shuki25/chess-board-iot/Schematic PDFs/chess-board-iot.pdf

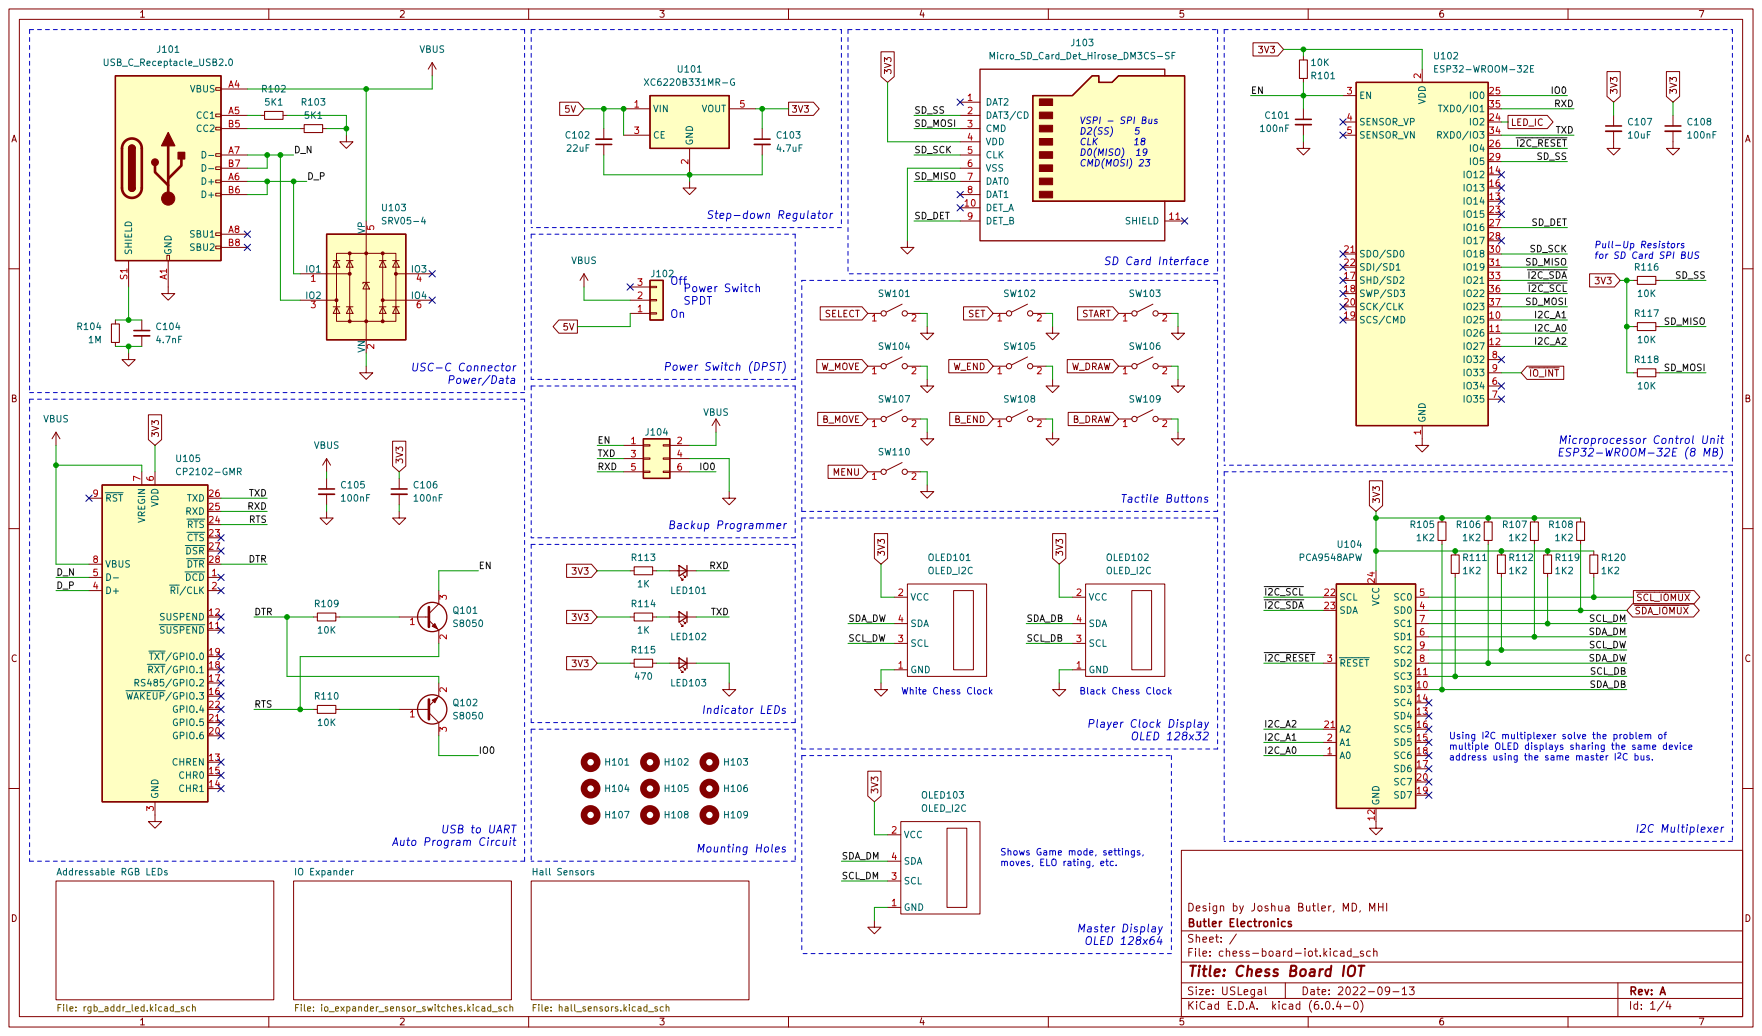
[picture p1: page 1]

2 SCK/CLK 20 SDO/SD0 21 SDI/SD1 22

SD Card Interface Player Clock Display OLED 128x32 Shows Game mode, settings,

Pull-Up Resistors
for SD Card SPI BUS Microprocessor Control Unit

Power Switch (DPST) Power Switch SPDT

SCL_DW
SDA_DW
SCL_DB

multiple OLED displays sharing the same device
address using the same master I^{2}C bus.

File: chess-board-iot.kicad_sch Sheet: / Butler Electronics Design by Joshua Butler, MD, MHI
D Date: 2022-09-13 KiCad E.D.A. kicad (6.0.4-0)

Id: 1/4 Title: Chess Board IOT

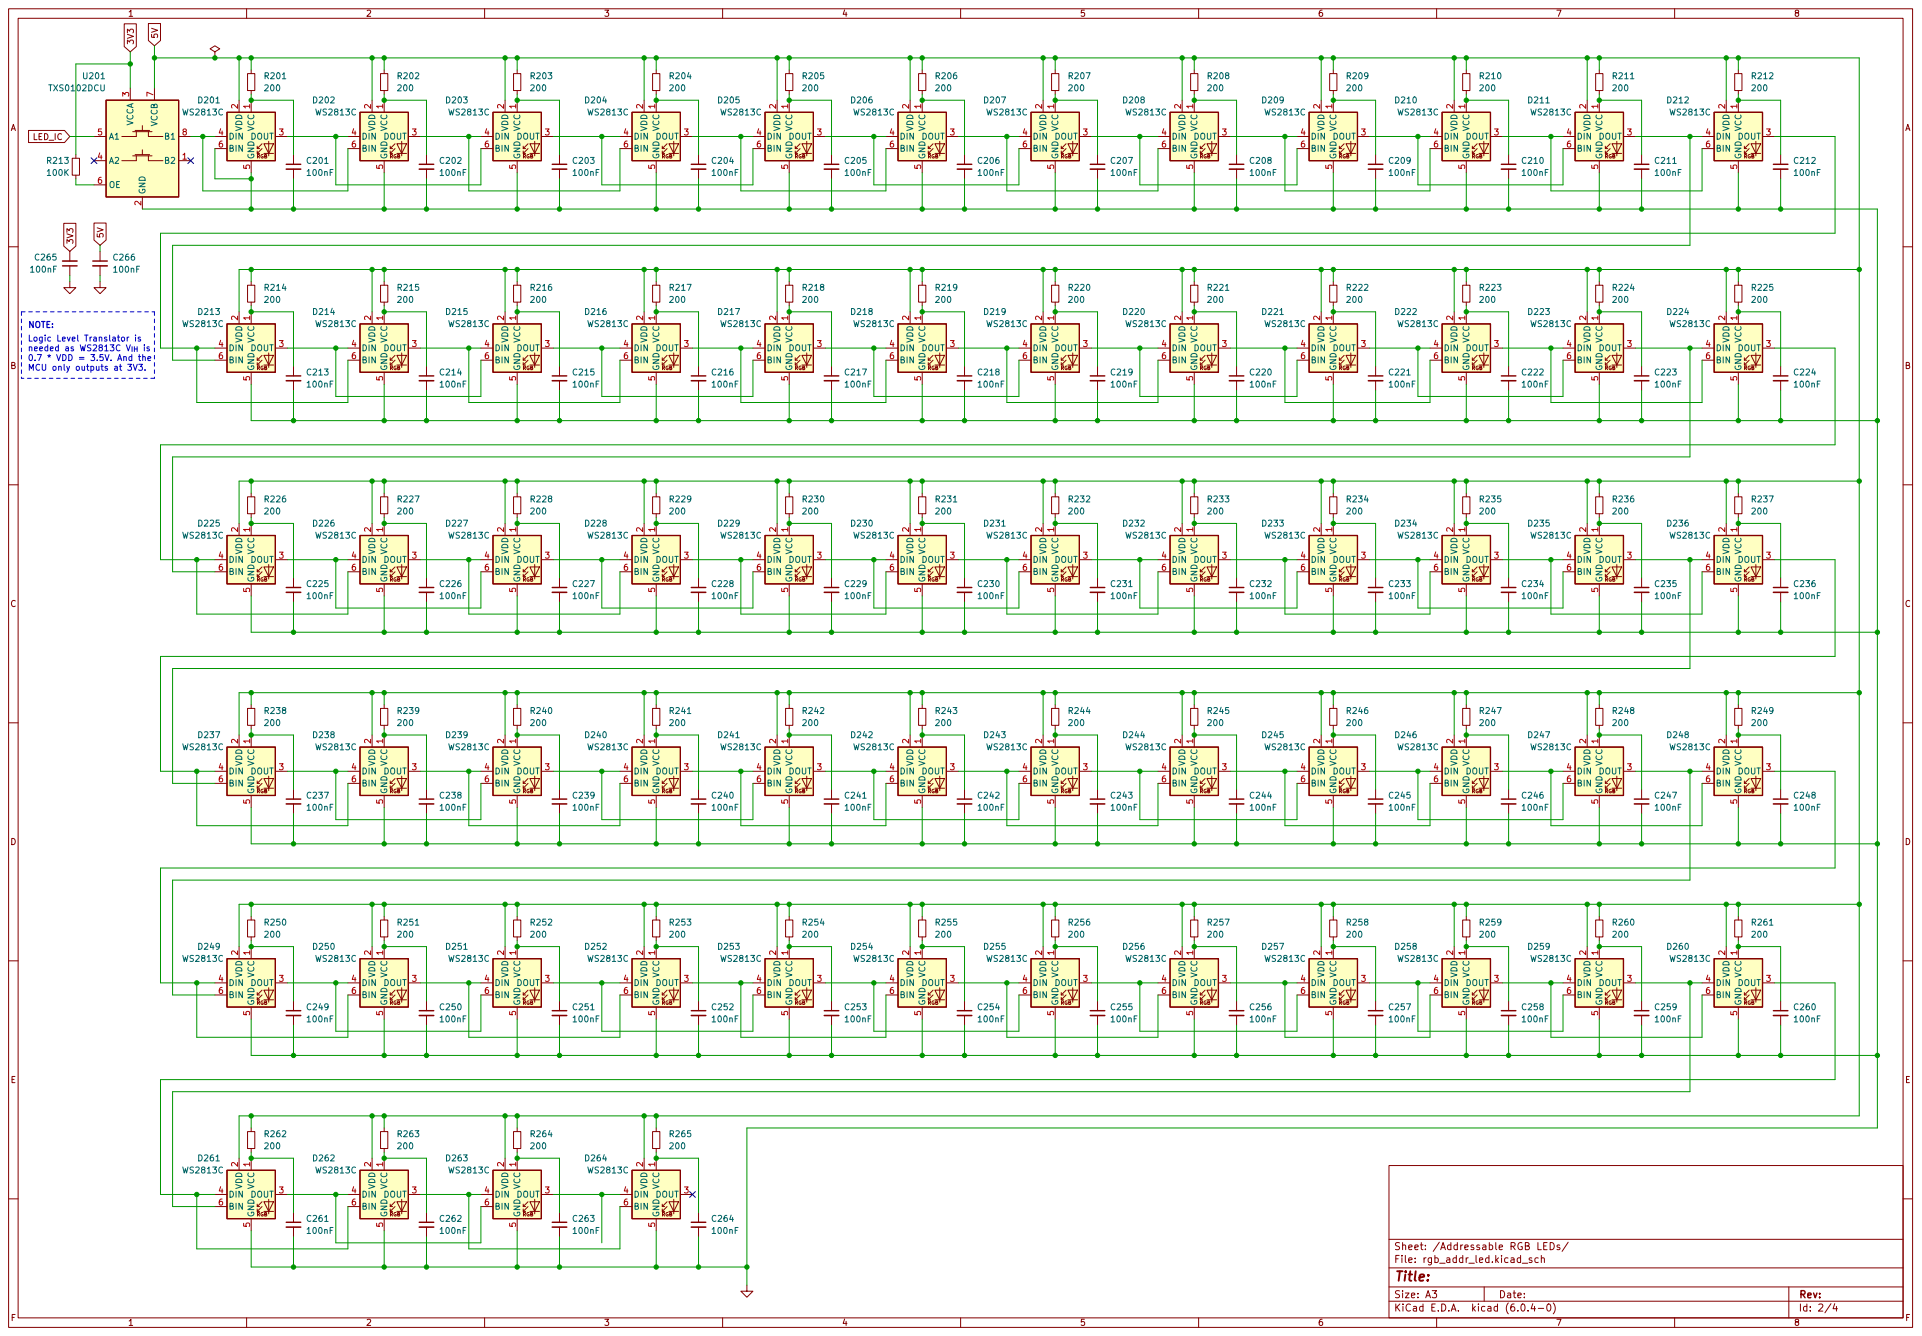
[picture p2: page 2]

needed as WS2813C V_{IH} is 0.7 * VDD = 3.5V. And the MCU only outputs at 3V3.

File: rgb_addr_led.kicad_sch Sheet: /Addressable RGB LEDs/

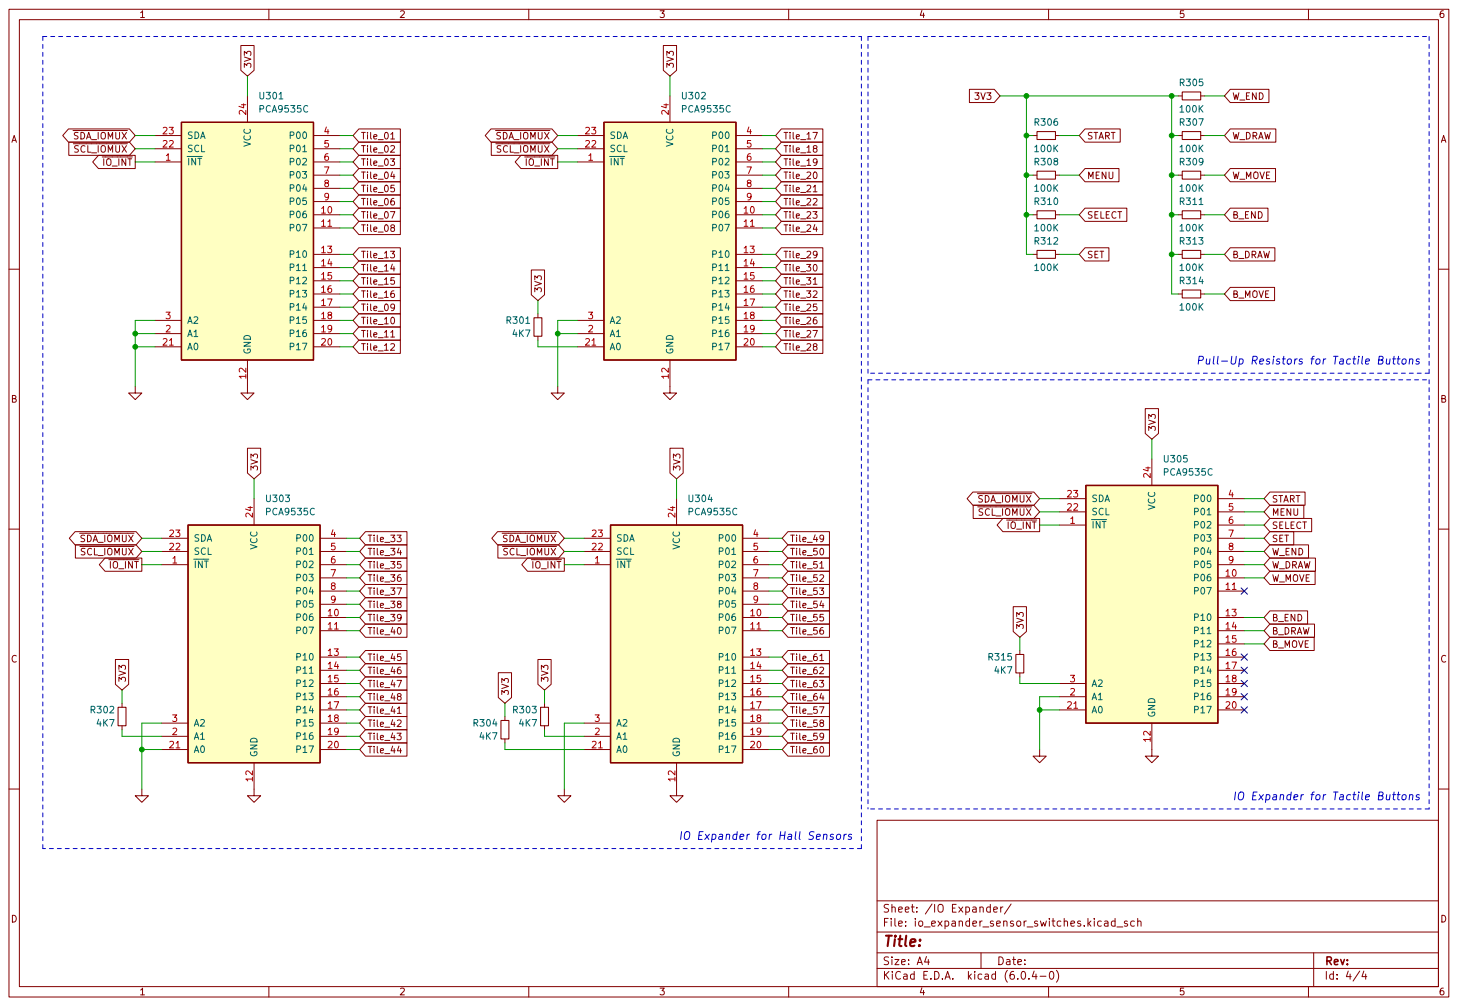
[picture p3: page 3]

Pull-Up Resistors for Tactile Buttons

IO Expander for Tactile Buttons

IO Expander for Hall Sensors

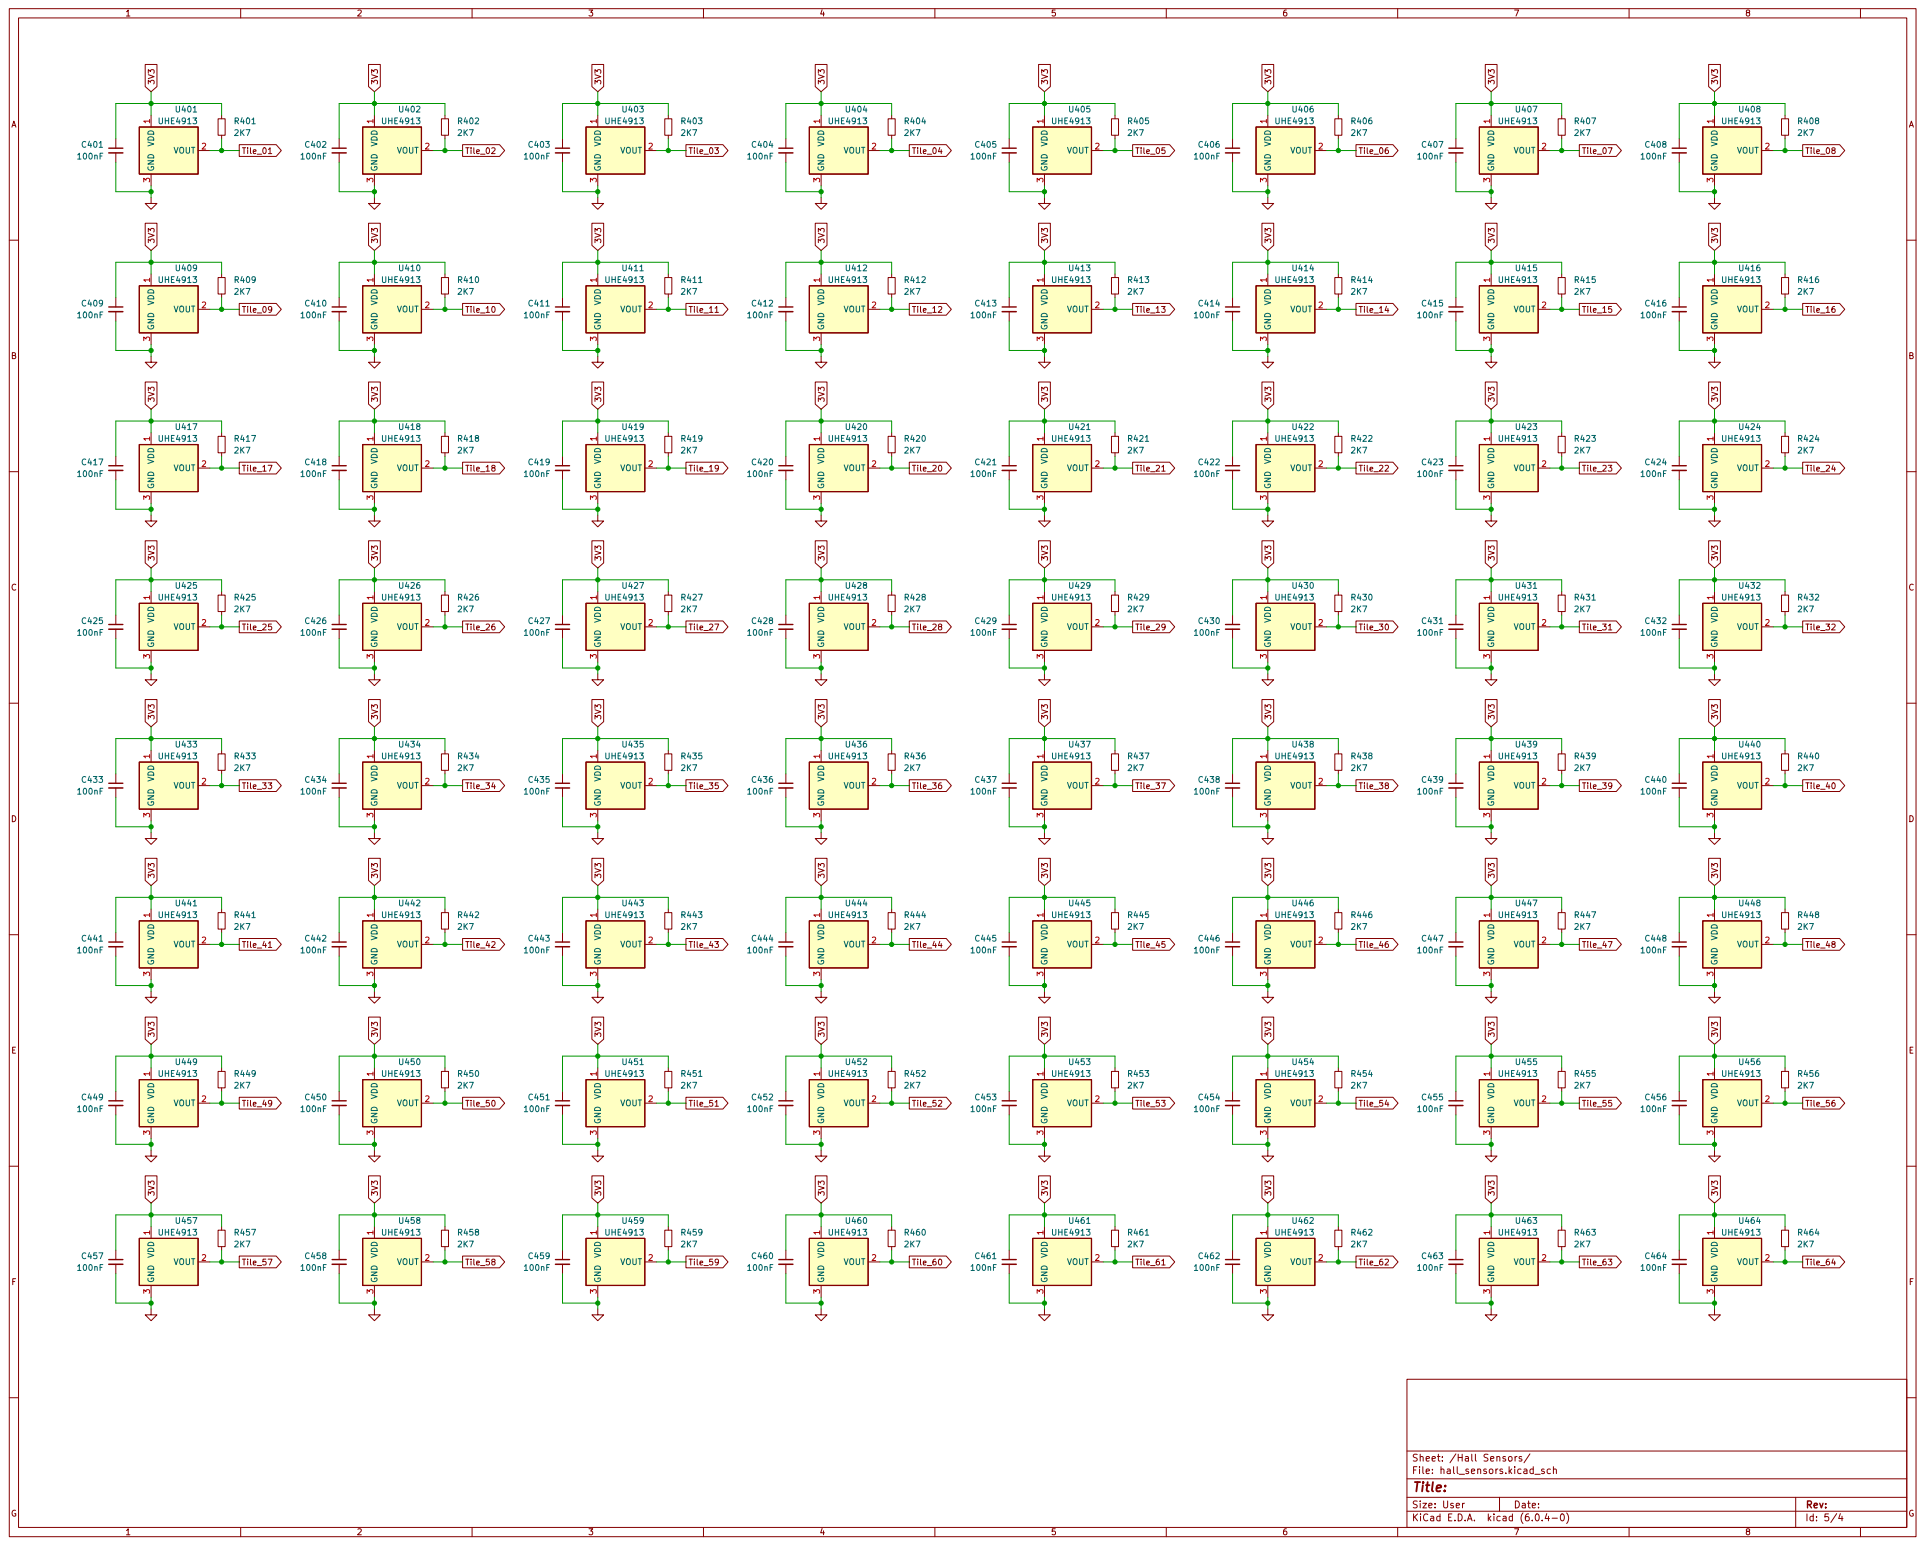
[picture p4: page 4]

File: hall_sensors.kicad_sch Sheet: /Hall Sensors/
