shuki25/chess-board-iot/(commit log)

2022-09-18 add hall sensors schematic
    [hall_sensors.kicad_sch]
2022-09-18 add reed switches schematic
    [reed_switches.kicad_sch]
2022-09-18 add addressable RGB LEDs
    [rgb_addr_led.kicad_sch]
2022-09-18 add I/O expander schematics
    [io_expander_reed_switches.kicad_sch, io_expander_sensor_switches.kicad_sch]
2022-09-18 update main schematic with hierarchical sheets
    [chess-board-iot.kicad_sch]
2022-09-18 initial PCB commit
    [chess-board-iot.kicad_pcb]
2022-09-18 add schematic PDFs
2022-09-19 update PCB layout
2022-09-19 update schematic with corrections
    [chess-board-iot.kicad_sch, hall_sensors.kicad_sch, io_expander_sensor_switches.kicad_sch]
2022-09-19 refactor IO expander pin assignment
    [io_expander_sensor_switches.kicad_sch]
2022-09-19 update PCB traces
2022-09-21 update schematic to include more components
    Added SD card
    Added IO expander for tactile buttons
    [chess-board-iot.kicad_sch, io_expander_sensor_switches.kicad_sch]
2022-09-21 add more components to PCB
2022-09-21 update schematic PDFs
2022-09-21 change wording from TTL to UART
    [chess-board-iot.kicad_sch]
2022-09-25 update schematics
    [chess-board-iot.kicad_sch]
2022-09-26 add level translator and fix OLED pin assignment
    [chess-board-iot.kicad_sch, rgb_addr_led.kicad_sch]
2022-09-26 add kicad and oshw logo
